hyperbob10/High_school_thesis/electronic_schematic.jpg

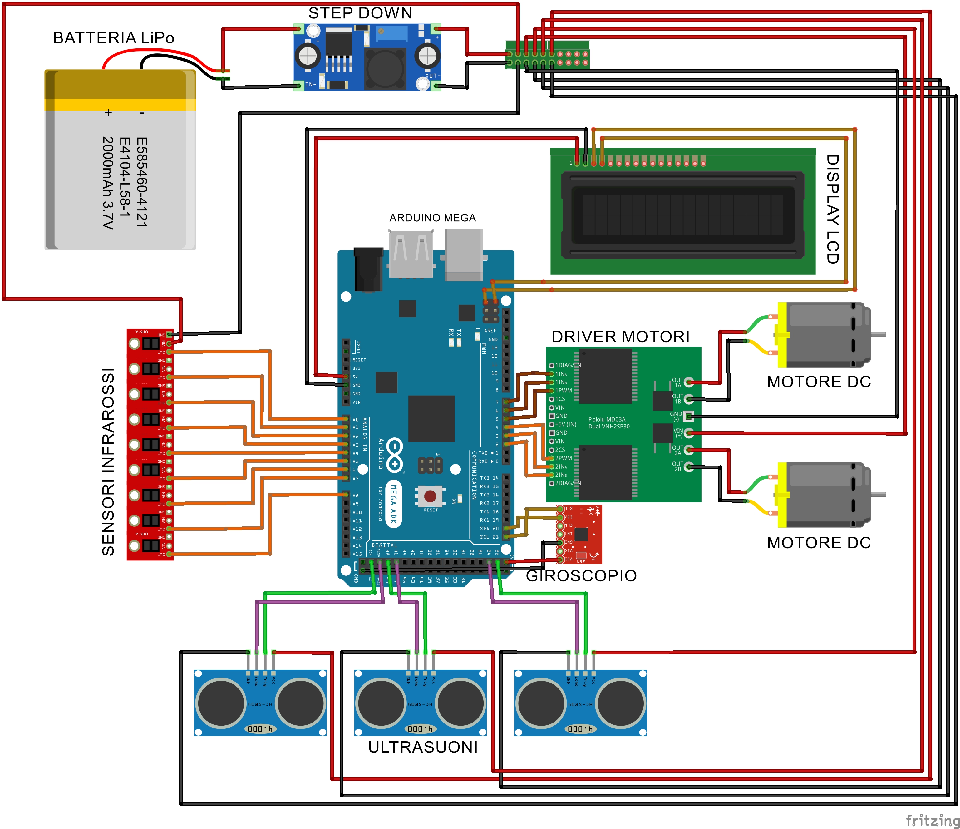
electronic_schematic.jpg
