hyperbob10/High_school_thesis/robot_pics/IMG_20170527_092008.jpg

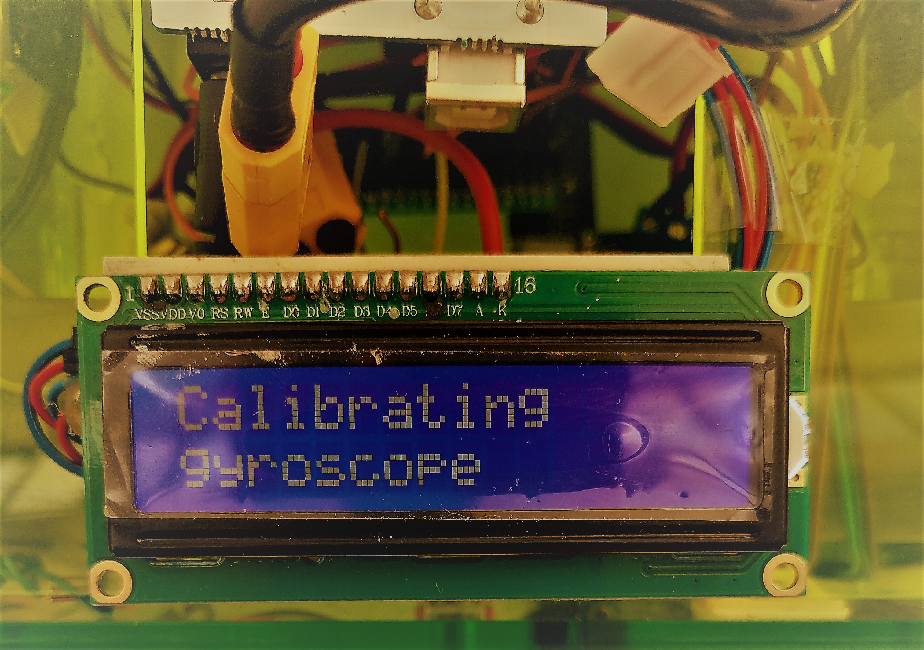
robot_pics/IMG_20170527_092008.jpg
