hyperbob10/High_school_thesis/robot_pics/IMG.jpg

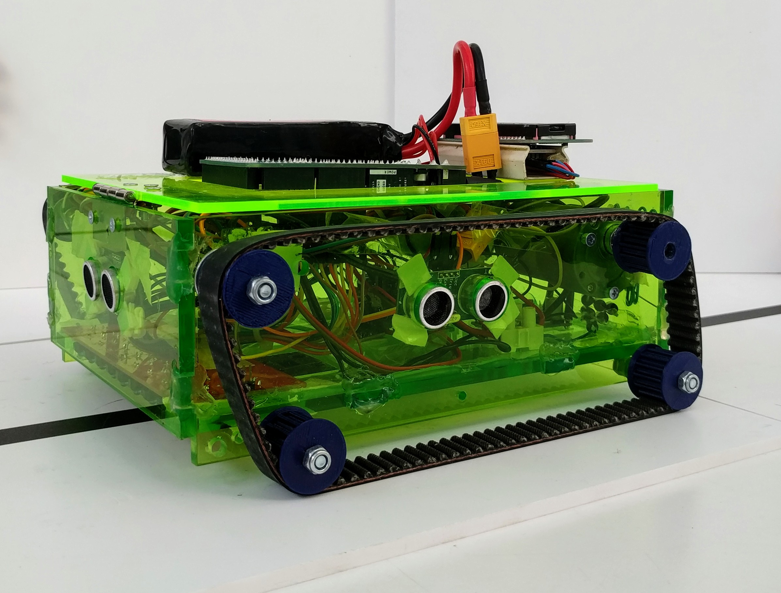
robot_pics/IMG.jpg
