hyperbob10/High_school_thesis/robot_pics/IMG_20170527_091643.jpg

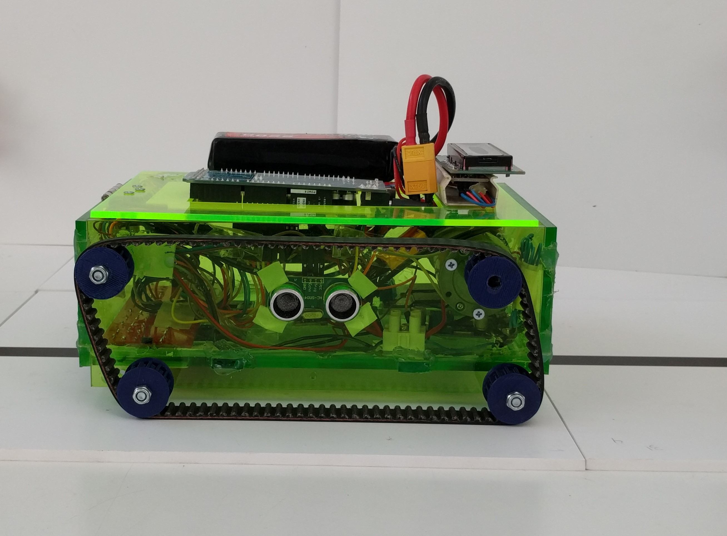
robot_pics/IMG_20170527_091643.jpg
