hyperbob10/High_school_thesis/robot_pics/IMG_20170616_162611a.jpg

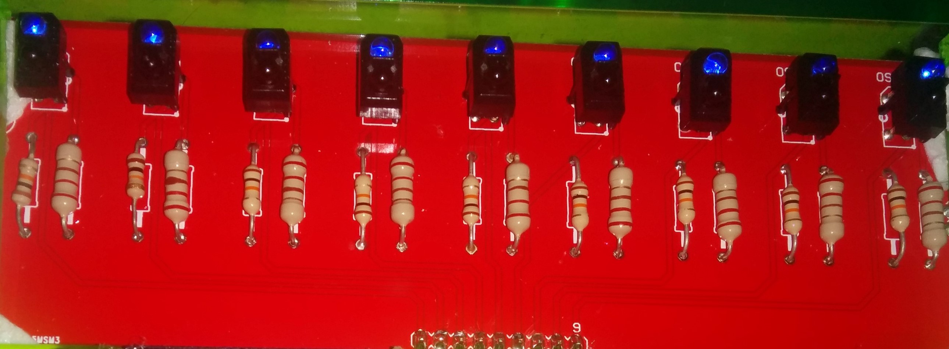
robot_pics/IMG_20170616_162611a.jpg
