hyperbob10/High_school_thesis/robot_pics/IMG_20170619_140515.jpg

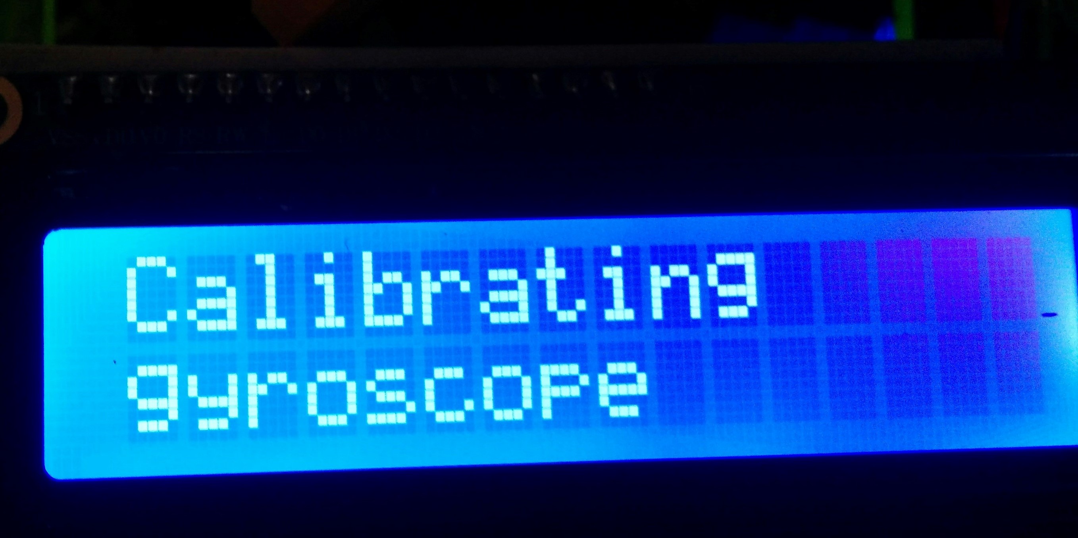
robot_pics/IMG_20170619_140515.jpg
