hyperbob10/High_school_thesis/mechanical_design/05 quote.pdf

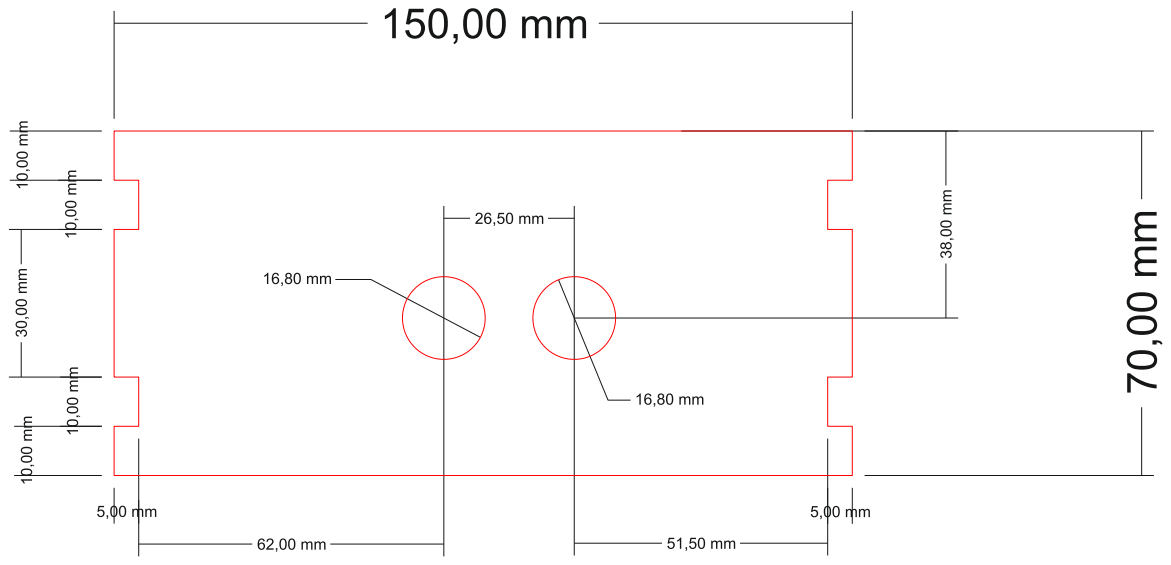
[picture p33: page 1]
