hyperbob10/High_school_thesis/mechanical_design/06 quote.pdf

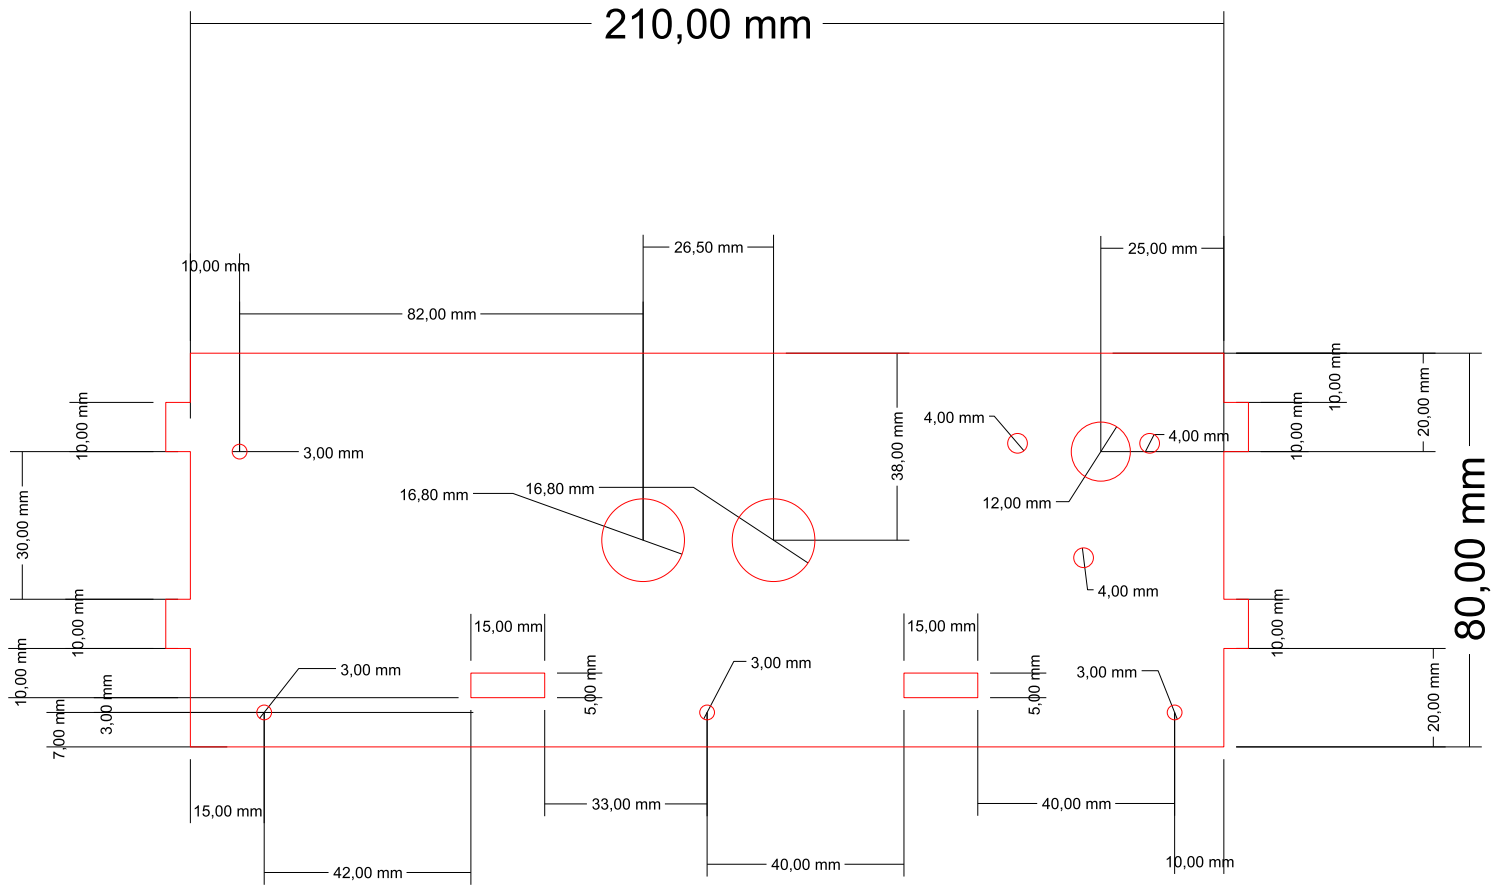
[picture p34: page 1]
