hyperbob10/High_school_thesis/mechanical_design/07 quote.pdf

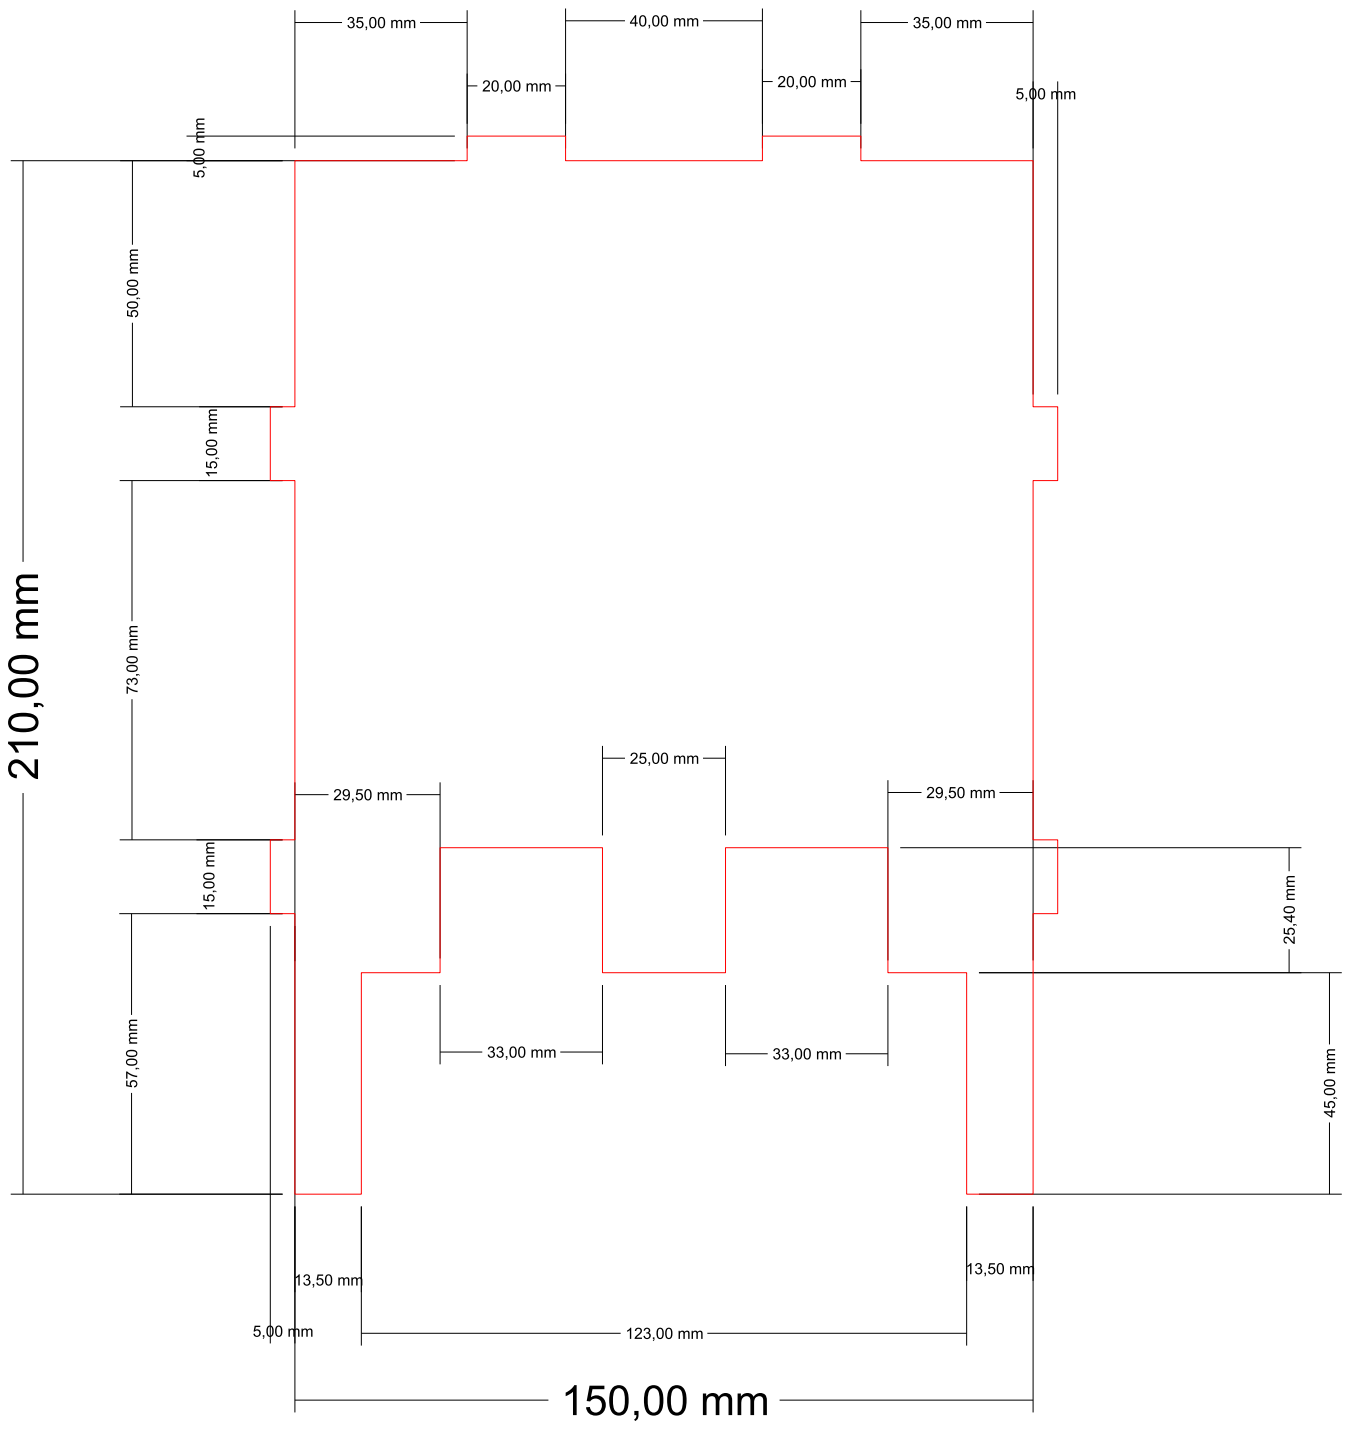
[picture p35: page 1]
