hyperbob10/High_school_thesis/mechanical_design/08 quote.pdf

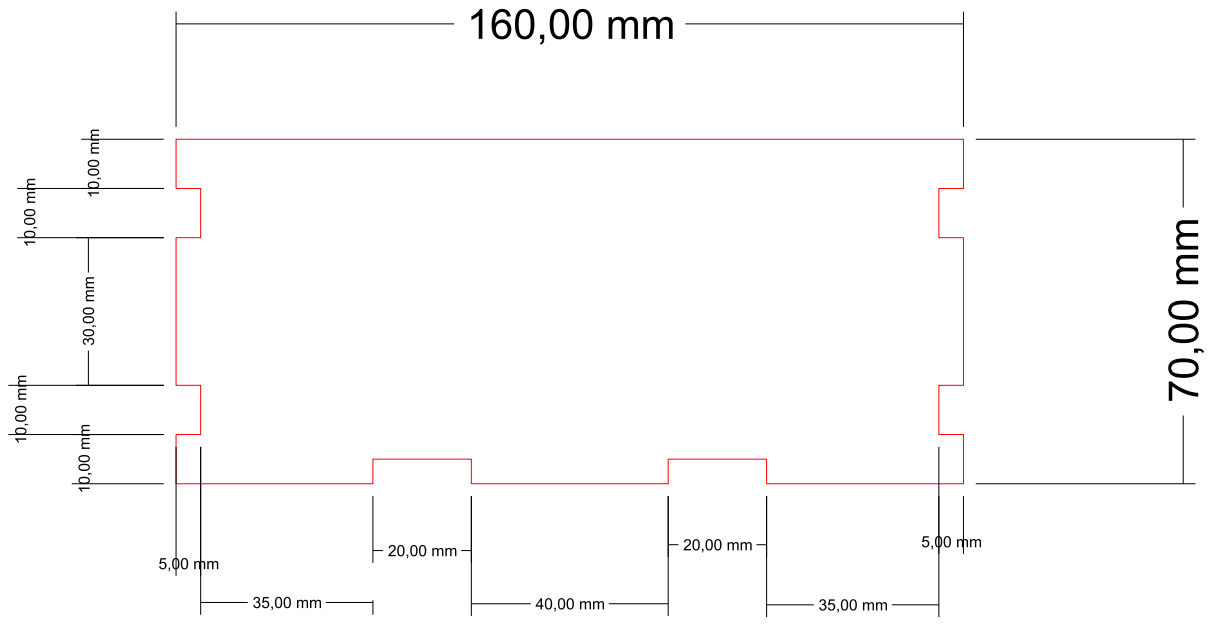
[picture p36: page 1]
