hyperbob10/High_school_thesis/code/costanti.h

//OUTPUT LIST

#define M2INA 7
#define M2INB 6
#define PWM2 5

#define M1INA 4
#define M1INB 3
#define PWM1 2
#define DX_S2 30
#define DX_S3 32
#define SX_S2 42
#define SX_S3 40
#define SX_OUT 44
#define DX_OUT 28
#define TRIG_FWD 48
#define TRIG_SX 52
#define TRIG_DX 22
#define ULTRA_FWD 46
#define ULTRA_DX 24
#define ULTRA_SX 50
#define SERVO 26
